atkaper/wifi-240v-ac-led-dimmer/images/20190928_153005-power-module-bottom.jpg

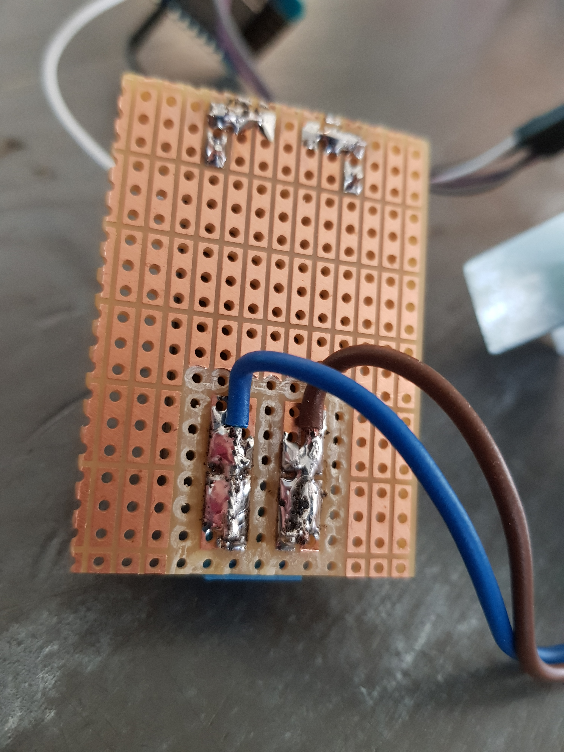
images/20190928_153005-power-module-bottom.jpg
