atkaper/wifi-240v-ac-led-dimmer/images/20191011_211720-avr-programmer-bottom.jpg

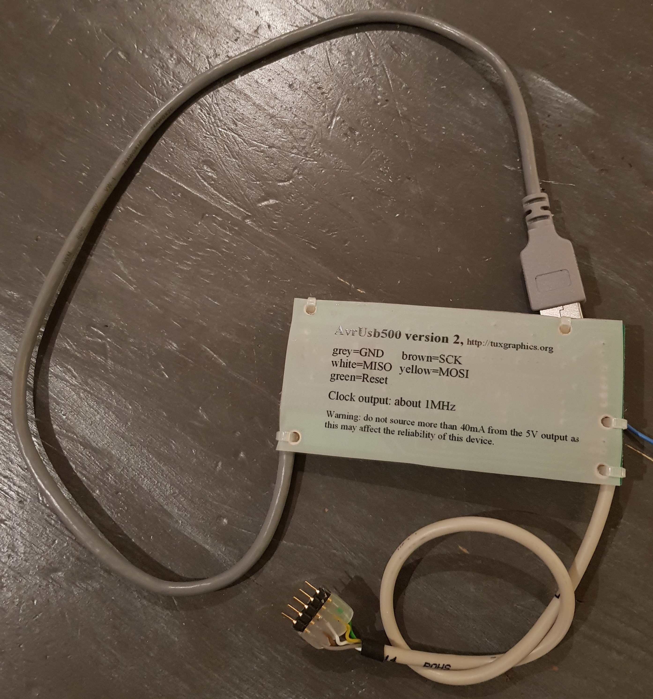
images/20191011_211720-avr-programmer-bottom.jpg
