atkaper/wifi-240v-ac-led-dimmer/images/20190928_152620-dimmer-version-1.jpg

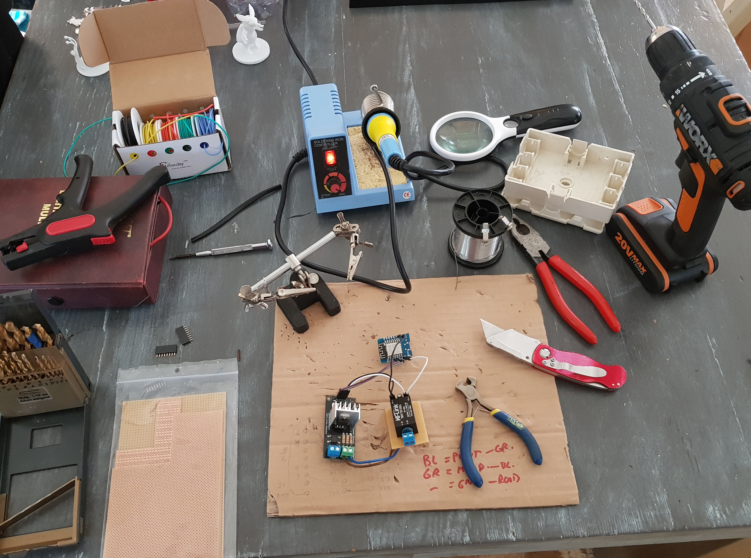
images/20190928_152620-dimmer-version-1.jpg
