atkaper/wifi-240v-ac-led-dimmer/images/20190928_152944-zero-cross-detector-and-triac.jpg

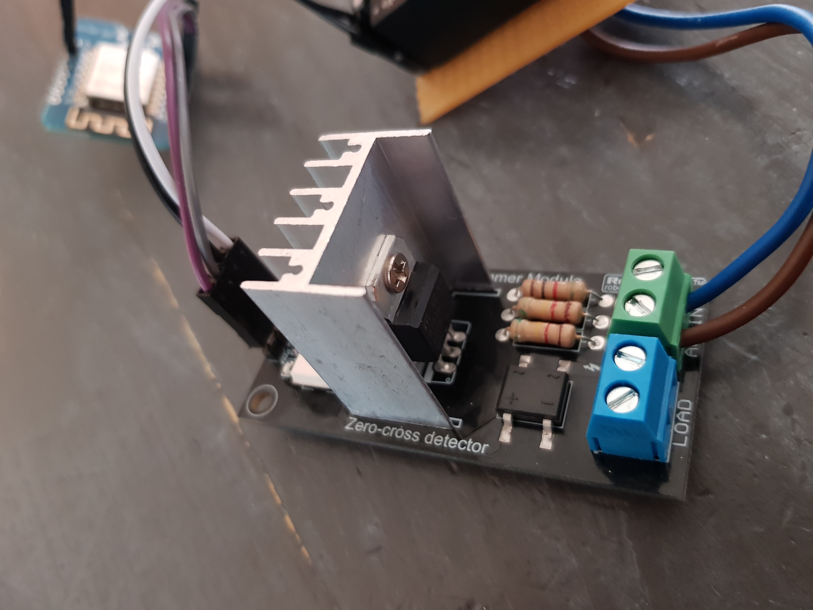
images/20190928_152944-zero-cross-detector-and-triac.jpg
