atkaper/wifi-240v-ac-led-dimmer/images/20190928_153014-zero-cross-detector-and-triac-bottom.jpg

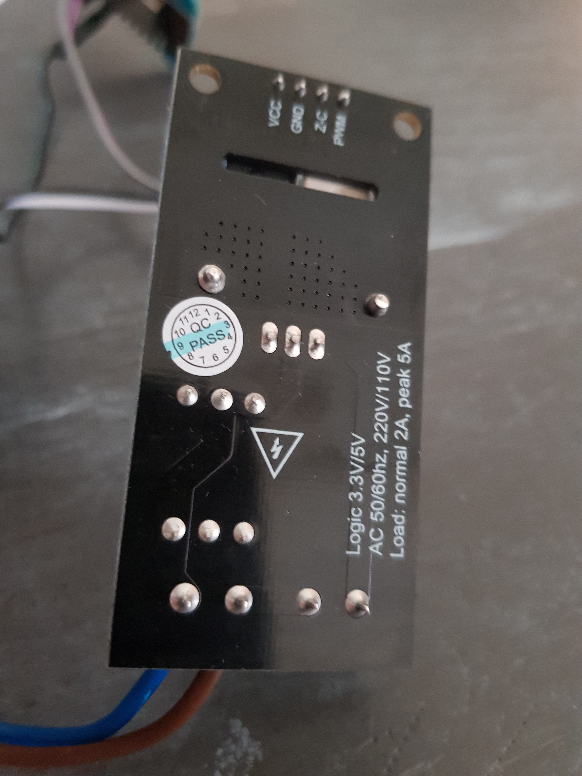
images/20190928_153014-zero-cross-detector-and-triac-bottom.jpg
