atkaper/wifi-240v-ac-led-dimmer/images/20191006_163129-bottom-of-analog-version.jpg

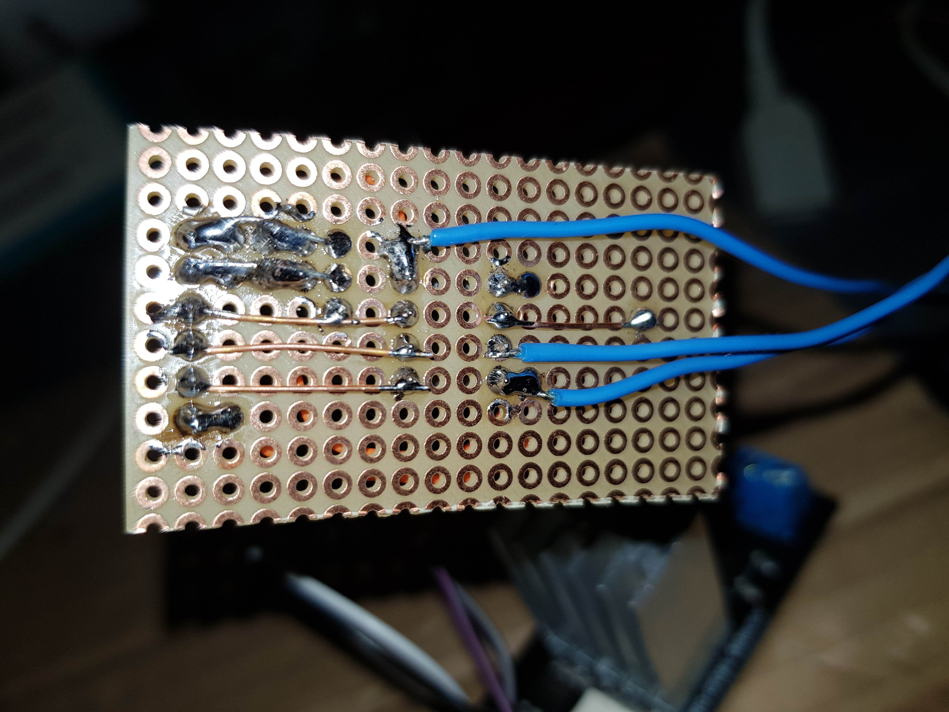
images/20191006_163129-bottom-of-analog-version.jpg
