atkaper/wifi-240v-ac-led-dimmer/images/20191012_230515-final-full-schematic.jpg

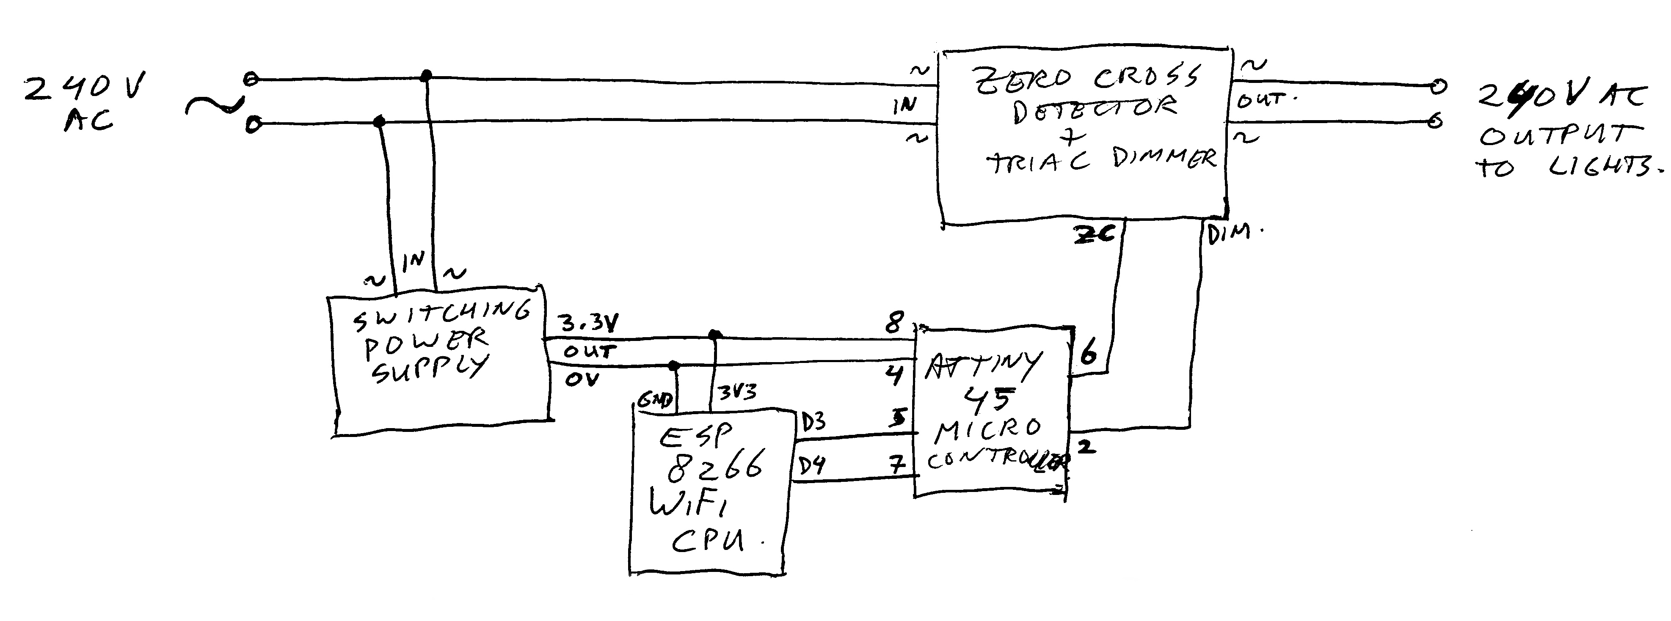
images/20191012_230515-final-full-schematic.jpg
