atkaper/wifi-240v-ac-led-dimmer/images/attiny45-internals.png

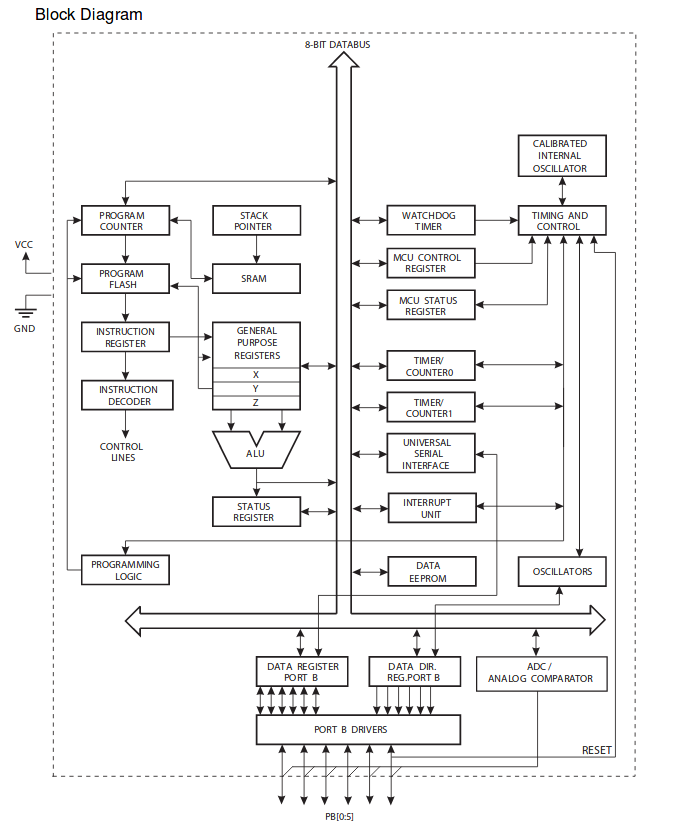
images/attiny45-internals.png
