atkaper/wifi-240v-ac-led-dimmer/images/attiny-potmeter-dimmer-inspiration-for-v2a.jpg

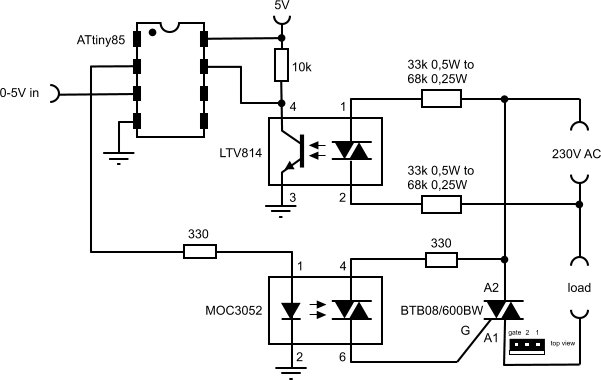
images/attiny-potmeter-dimmer-inspiration-for-v2a.jpg
