atkaper/wifi-240v-ac-led-dimmer/images/forward-phase-dimming.png

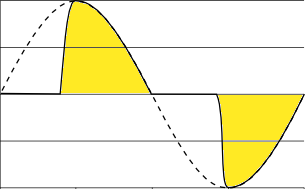
images/forward-phase-dimming.png
