atkaper/wifi-240v-ac-led-dimmer/images/zero-cross-detection-triac-module-schematics.png

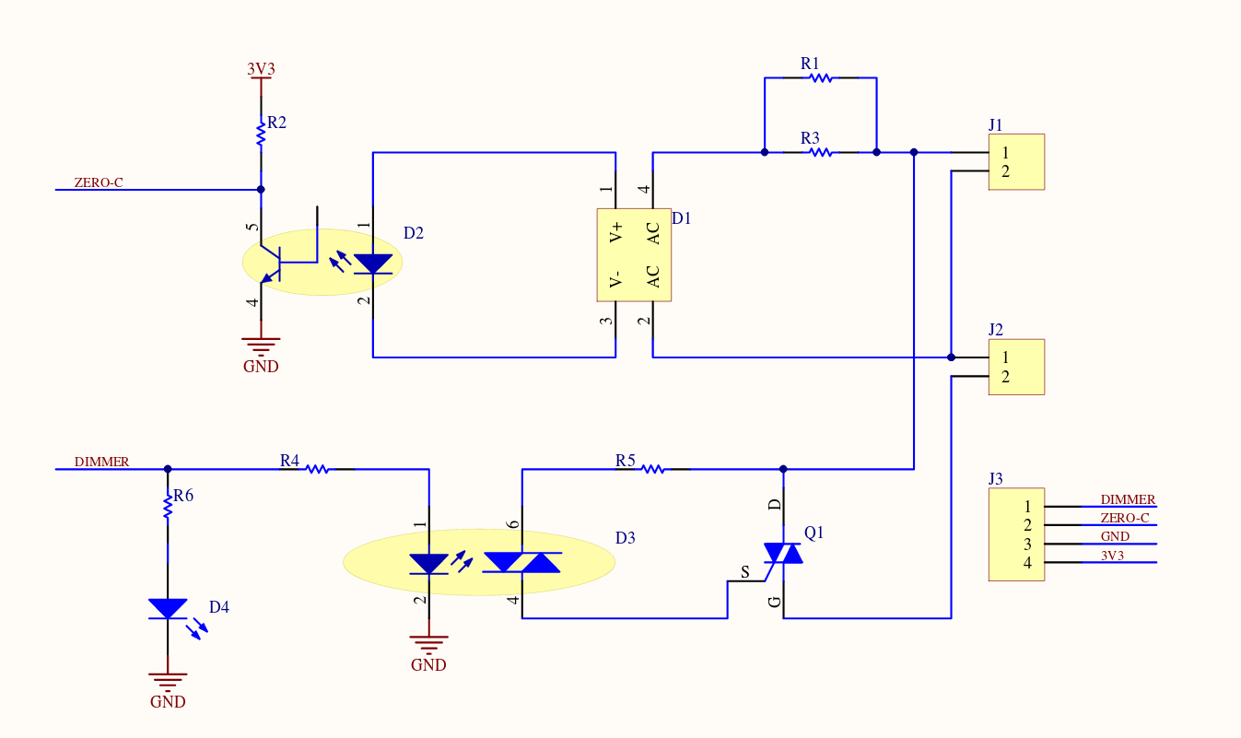
images/zero-cross-detection-triac-module-schematics.png
