atkaper/wifi-240v-ac-led-dimmer/images/20190928_152920-dimmer-version-1-closeup.jpg

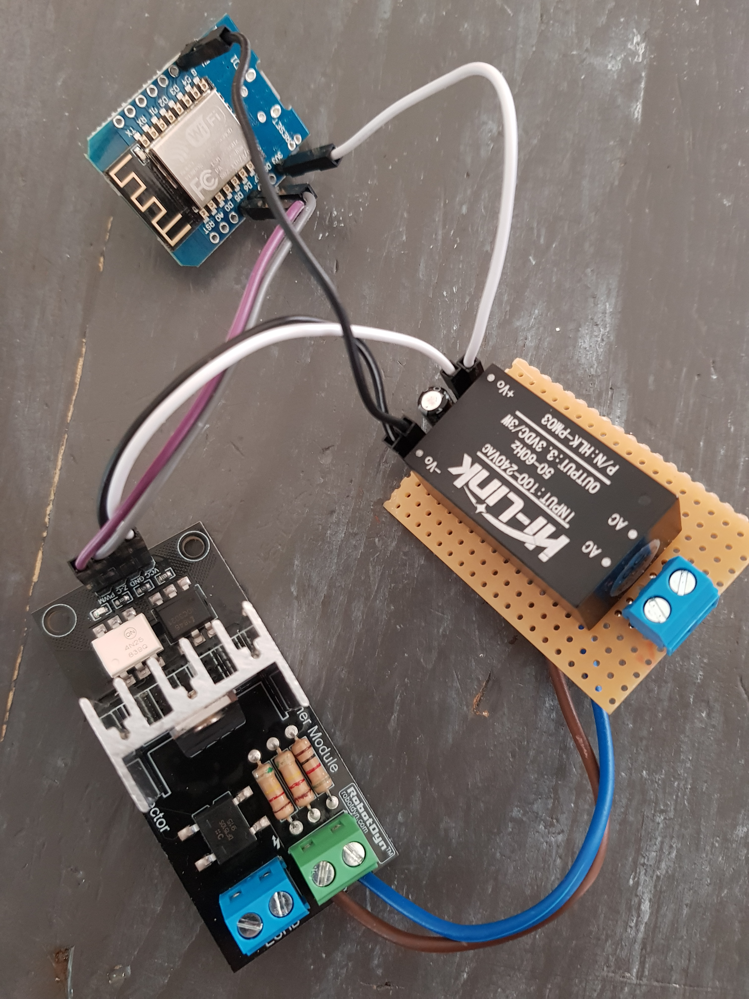
images/20190928_152920-dimmer-version-1-closeup.jpg
