atkaper/wifi-240v-ac-led-dimmer/images/20191007_220929-version-3-coprocessor-and-esp8266-wifi-master.jpg

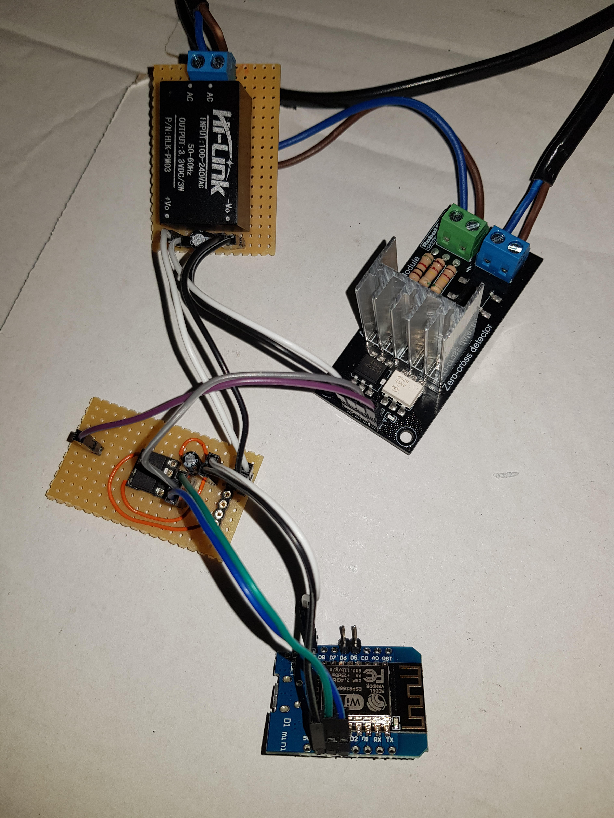
images/20191007_220929-version-3-coprocessor-and-esp8266-wifi-master.jpg
